evrenkenanoglu/smart_plugs_hw_design/UTILITY/JLCPCB_useful_component_list.md

# JLCPCB Useful Component List

BUTTONS
| Supplier Part | Description |
| --- | --- |
| C455095 | 6x6x7mm Tactile Switch |
