evrenkenanoglu/smart_plugs_hw_design/DESIGN/ESP32_RELATED/ESP32-S3-WROOM-1-N8R8.md

Here is the updated design note. I have integrated the detailed Strapping Pin configuration rules into **Section 4**, explaining exactly how to handle GPIO 0, 45, 46, and 3 to ensure the N8R8 module boots correctly every time.

```markdown
# Design Note: ESP32-S3 Headless Programming Interface
**Module:** ESP32-S3-WROOM-1-N8R8  
**Strategy:** No User UART. Factory Programming via 6-Pin Header only.  
**Logic:** Auto-Program Circuit (Transistors) located on External Tool.

## 1. Schematic Diagram (ASCII)

```text
       [ EXTERNAL PROGRAMMER ]                 [ YOUR PCB ]
       (USB to TTL + Auto-Logic)          (Internal Components)

      +-------------------------+        +---------------------------+
      |                         |        |                           |
      |   FTDI / ESP-PROG       |        |   ESP32-S3-WROOM-1        |
      |      (External)         |        |      (Top View)           |
      |                         |        |                           |
      +------------+------------+        +-------------+-------------+
                   |                                   |
           [ 6-PIN CONNECTOR ]                  [ MODULE PINS ]
                   |                                   |
                   v                                   v
      +-------------------------+        +---------------------------+
      |  1. GND                 |--------| Pin 1, 40, 41, 42 (GND)   |
      |                         |        |                           |
      |  2. 3V3 (Target Power)  |---+----| Pin 2 (3V3)               |
      |                         |   |    |                           |
      |                         | [C1,C2]|                           |
      |                         |   |    |                           |
      |                         |  GND   |                           |
      |                         |        |                           |
      |  3. TXD (Log Output)    |--------| Pin 37 (GPIO 43 / U0TXD)  |
      |                         |        |                           |
      |  4. RXD (Data Input)    |--------| Pin 36 (GPIO 44 / U0RXD)  |
      |                         |        |                           |
      |  5. IO0 (Boot Control)  |---+----| Pin 27 (GPIO 0 / BOOT)    |
      |                         |   |    |                           |
      |                         |  [R2]  |                           |
      |                         |   |    |                           |
      |                         |  3V3   |                           |
      |                         |        |                           |
      |  6. RST (Chip Reset)    |---+----| Pin 3 (EN / CHIP_PU)      |
      |                         |   |    |                           |
      |                         |  [R1]  |                           |
      |                         |   |    |                           |
      |                         |  3V3   |                           |
      |                         |        |                           |
      |                         |  [C3]  |                           |
      |                         |   |    |                           |
      |                         |  GND   |                           |
      +-------------------------+        +---------------------------+
```

---

## 2. Component Values (BOM)

| Component | Value | Function | Placement Note |
| :--- | :--- | :--- | :--- |
| **C1** | **10µF** (10V+) | Bulk Power Storage | Close to Module Pin 2 |
| **C2** | **0.1µF** (100nF) | High Freq Decoupling | **Closest** to Module Pin 2 |
| **R1** | **10kΩ** | EN Pull-Up | Anywhere on EN net |
| **C3** | **1µF** | EN RC Delay (Reset Timing) | Close to Module Pin 3 |
| **R2** | **10kΩ** | IO0 Pull-Up (Stability) | Anywhere on IO0 net |

### Connection Diagram of 10uF and 0.1uF Capacitors

```text
      3.3V Source (LDO)
            |
            +-------------+-------------+----------------> Pin 2 (ESP32 3V3)
            |             |             |
          [ C1 ]        [ C2 ]          |
           10µF         0.1µF           |
            |             |             |
      ------+-------------+-------------+----------------> GND
            |
         GND Plane
```

### Physical Layout (Crucial)
While they are electrically in parallel, their **physical position** on the PCB matters:

1.  **Pin 2 (ESP32):** The target.
2.  **C2 (0.1µF):** Place this **closest** to Pin 2. It filters high-frequency noise.
3.  **C1 (10µF):** Place this right behind C2. It acts as a customized energy reservoir.

**Order on PCB:** `[Pin 2] <--- [0.1µF] <--- [10µF] <--- [Power Source]`

---

## 3. Pin Mapping Table (Netlist)

This mapping assumes a standard 1x6 Pin Header (2.54mm) on the PCB.

| Header Pin | Net Name | ESP32-S3 Pin | ESP32 Function | Description |
| :--- | :--- | :--- | :--- | :--- |
| **1** | `GND` | **1, 40, 41, 42** | GND | Common Ground |
| **2** | `+3V3` | **2** | 3V3 | Power for flashing (if unpowered) |
| **3** | `UART_TX` | **37** | GPIO 43 | **U0TXD** (Serial Output) |
| **4** | `UART_RX` | **36** | GPIO 44 | **U0RXD** (Serial Input) |
| **5** | `PROG_IO0`| **27** | GPIO 0 | Boot Mode Selection |
| **6** | `PROG_RST`| **3** | EN | Chip Enable / Reset |

---

## 4. Strapping Pin Configuration (Crucial)

These pins are sampled at the moment of Reset (Latch). Incorrect connections here will prevent the board from booting or cause "ghost" failures.

| Module Pin | Function | Schematic Action | Why? |
| :--- | :--- | :--- | :--- |
| **GPIO 0** (Pin 27) | Boot Mode | **10kΩ Pull-Up** | Must be HIGH to run code. External tool pulls LOW to flash. |
| **GPIO 46** (Pin ?) | ROM Log / Voltage | **FLOAT** (Do not connect) | Default is Pull-Down (0). Pulling HIGH can disable ROM messages or change boot voltage. |
| **GPIO 45** (Pin 26) | VDD_SPI Voltage | **FLOAT** (Do not connect) | Default is Pull-Down (0) for 3.3V Flash. Pulling HIGH forces 1.8V, which kills communication with N8R8 Flash. |
| **GPIO 3** (Pin 18) | JTAG | **FLOAT** (Do not connect) | Default is Floating. No action needed unless using JTAG. |

**Golden Rule:** If you have extra pins available, leave GPIO 46, 45, and 3 completely unconnected to ensure maximum stability.

---

## 5. Layout & Tooling Notes

1.  **Thermal Pad (Pin 42):**
    *   Must be connected to **GND**.
    *   Add at least **9 vias** on the PCB footprint to the bottom ground plane for heat dissipation.
2.  **External Programmer Tool:**
    *   Use a tool like **ESP-Prog** or a USB-TTL adapter with **Auto-Program Logic**.
    *   *Standard 6-pin FTDI cables will NOT work for auto-upload unless you manually manipulate wires.*
```
