evrenkenanoglu/smart_plugs_hw_design/DESIGN/SCRIPTS/POWER_CALCULATIONS/Power_Calculations/Report_Main_Power_Board.md

# 🏗️ PCB ENGINEERING REPORT: Smart Plug System v2 - Main_Power_Board
**Date:** 2026-03-03  
**Spec:** 1.0oz Copper | 230.0V AC | 5.0V DC  
**Standard:** IPC-2221 / IEC 60950-1  

---

## 🔋 PART 1: POWER SUPPLY LOAD ANALYSIS
**Objective:** Verify if `HLK-10M05` (2000.0 mA) can handle the Worst-Case Peak loads.

| COMPONENT | PEAK (mA)| QTY | CURRENT (mA) | TOTAL (mA) |
| :--- | :--- | :--- | :--- | :--- |
| HF115F Relay Coils | 5.0V | 4 | 80.0 | 320.0 |
| ESP32-WROOM-32UE | 3.3V | 1 | 700.0 | 700.0 |
| UI Board Feed (LEDs) | 5.0V | 4 | 12.0 | 48.0 |

* **TOTAL PEAK:** `1068.0 mA`
* **DESIGN LOAD (+20%):** `1281.6 mA`
* **STATUS:** ✅ **PASS**

---

## ⚡ PART 2: AC HIGH POWER ANALYSIS
| LINE NAME | VOLTAGE | MAX AMPS | POWER (kW) |
| :--- | :--- | :--- | :--- |
| AC_LOAD_16A | 230.0V | 16.000 A | 3.680 kW |
| AC_MAINS_INPUT_LOGIC | 230.0V | 0.200 A | 0.046 kW |
| AC_MAINS_INPUT | 230.0V | 0.040 A | 0.009 kW |

---

## 📏 PART 3: TRACE WIDTH RULES
**Parameters:** 1.0oz Copper, +10°C Rise.

| NET FUNCTION | LOAD (A) | MIN WIDTH (Calc) | **ALTIUM RULE (Rec)** |
| :--- | :--- | :--- | :--- |
| AC_LOAD_16A | 16.000 | 13.837 mm | **POLYGON POUR** |
| AC_MAINS_INPUT_LOGIC | 0.200 | 0.250 mm | **1.00 mm** (Mech) |
| AC_MAINS_INPUT | 0.040 | 0.250 mm | **1.00 mm** (Mech) |
| DC_IN_5.0V | 1.282 | 0.425 mm | **1.10 mm** (SF=2.5) |
| DC_3V3_RAIL | 0.700 | 0.250 mm | **0.65 mm** (SF=2.5) |
| DC_RELAY_GND | 0.320 | 0.250 mm | **0.65 mm** (SF=2.5) |
| DC_SIGNAL | 0.050 | 0.250 mm | **0.25 mm** |

> **⚠️ CRITICAL NOTE for AC_LOAD_20A:**  
> Use a **Solid Polygon Pour** connecting the Relay Pin to the Faston Tab.

---

## 🛡️ PART 4: SAFETY SPACING RULES
**Standards:** IEC 60950-1 (Pollution Degree 2).

| ZONE A | ZONE B | STD CLEARANCE | STD CREEPAGE | **RECOMMENDED RULE** |
| :--- | :--- | :--- | :--- | :--- |
| AC Phase | AC Neutral | 1.5 mm | 2.5 mm | **3.0 mm** (Robust) |
| AC Mains | DC Logic | 3.0 mm | 5.0 mm | **6.0 mm** (or Slot) |
| AC Relay Pin | Faston Tab | N/A | N/A | **Connect w/ Polygon** |
| DC 5V | DC GND | 0.15 mm | 0.15 mm | **0.25 mm** |

---
*Generated by PCB Engineering Assistant*
