evrenkenanoglu/smart_plugs_hw_design/DESIGN/SCRIPTS/POWER_CALCULATIONS/Power_Calculations/Report_UI_Control_Board.md

# 🏗️ PCB ENGINEERING REPORT: Smart Plug System v2 - UI_Control_Board
**Date:** 2026-03-03  
**Spec:** 1.0oz Copper | 0.0V AC | 5.0V DC  
**Standard:** IPC-2221 / IEC 60950-1  

---

## 🔋 PART 1: POWER SUPPLY LOAD ANALYSIS
**Objective:** Verify if `HLK-10M05` (2000.0 mA) can handle the Worst-Case Peak loads.

| COMPONENT | PEAK (mA)| QTY | CURRENT (mA) | TOTAL (mA) |
| :--- | :--- | :--- | :--- | :--- |
| Status LEDs | 5.0V | 4 | 12.0 | 48.0 |
| Tactile Buttons | 0.0V | 4 | 1.0 | 4.0 |

* **TOTAL PEAK:** `52.0 mA`
* **DESIGN LOAD (+15%):** `59.8 mA`
* **STATUS:** ✅ **PASS**

---

## ⚡ PART 2: AC HIGH POWER ANALYSIS
| LINE NAME | VOLTAGE | MAX AMPS | POWER (kW) |
| :--- | :--- | :--- | :--- |
| N/A | N/A | N/A | N/A |

---

## 📏 PART 3: TRACE WIDTH RULES
**Parameters:** 1.0oz Copper, +10°C Rise.

| NET FUNCTION | LOAD (A) | MIN WIDTH (Calc) | **ALTIUM RULE (Rec)** |
| :--- | :--- | :--- | :--- |
| DC_IN_5.0V | 0.060 | 0.250 mm | **0.25 mm** |
| DC_3V3_RAIL | 0.004 | 0.250 mm | **0.25 mm** |
| DC_SIGNAL | 0.050 | 0.250 mm | **0.25 mm** |

> **⚠️ CRITICAL NOTE for AC_LOAD_20A:**  
> Use a **Solid Polygon Pour** connecting the Relay Pin to the Faston Tab.

---

## 🛡️ PART 4: SAFETY SPACING RULES
**Standards:** IEC 60950-1 (Pollution Degree 2).

| ZONE A | ZONE B | STD CLEARANCE | STD CREEPAGE | **RECOMMENDED RULE** |
| :--- | :--- | :--- | :--- | :--- |
| AC Phase | AC Neutral | 1.5 mm | 2.5 mm | **3.0 mm** (Robust) |
| AC Mains | DC Logic | 3.0 mm | 5.0 mm | **6.0 mm** (or Slot) |
| AC Relay Pin | Faston Tab | N/A | N/A | **Connect w/ Polygon** |
| DC 5V | DC GND | 0.15 mm | 0.15 mm | **0.25 mm** |

---
*Generated by PCB Engineering Assistant*
