evrenkenanoglu/smart_plugs_hw_design/DESIGN/SCRIPTS/POWER_CALCULATIONS/Led_Calculations/report.md

# UI LED Calculation & BOM Report

| Component Name | Source | Target mA | Req. Ω | E24 Choice | Power (mW) |
| :--- | :--- | :--- | :--- | :--- | :--- |
| System Status (White) | 3.3V | 12 | 33.3Ω | **33Ω** | 4.8 |
| System Status (White) | 5.0V | 11 | 190.9Ω | **200Ω** | 24.2 |
