evrenkenanoglu/smart_plugs_hw_design/PCB_DESIGN/Smart_Plugs_EasyEDA/Releases/v0.3.0/BOM_Combined_PCB_COMBINED_2026-03-11_v0.3.0.csv

No. | Quantity | Comment | Designator | Footprint | Value | Manufacturer Part | Manufacturer | Supplier Part | Supplier
1 | 1 | 100nF | C1 | CAP-TH_L4.0-W2.5-P5.00-D1.0 | 100nF | FG28X7R1H104KNT06 | TDK | C342794 | LCSC
2 | 1 | 100nF | C2 | CAP-TH_L13.0-W6.0-P10.00-D1.0 | 100nF | MP2104K27C3X6LC | SRD(圣融达) | C105759 | LCSC
3 | 2 | 10uF | C3,C11 | C0603 | 10uF | CL10A106KP8NNNC | SAMSUNG(三星) | C19702 | LCSC
4 | 1 | 10uF | C4 | CAP-TH_BD10.0-P5.00-D1.0-FD | 10uF | EGD2WM100G16OT | AISHI(艾华集团) | C106328 | LCSC
5 | 7 | 100nF | C5,C6,C7,C9,C12,C13,C14 | C0402 | 100nF | CL05B104KO5NNNC | SAMSUNG(三星) | C1525 | LCSC
6 | 1 | 1uF | C8 | C0402 | 1uF | CL05A105KO5NNNC | SAMSUNG(三星) | C29266 | LCSC
7 | 1 | 22uF | C10 | C1206 | 22uF | CL31A226KAHNNNE | SAMSUNG(三星) | C12891 | LCSC
8 | 2 | XH-12A | CN1,CN2 | CONN-TH_12P-P2.50_XH-12A |  | XH-12A | BOOMELE(博穆精密) | C8880 | LCSC
9 | 1 | 2.2nF | CY1 | CAP-TH_L8.5-W5.0-P10.00-D0.6 | 2.2nF | Y16F1D222M | HEL(鸿志) | C332369 | LCSC
10 | 2 | 220uF | C_BULK1,C_BULK2 | CAP-TH_BD6.3-P2.50-D1.0-FD | 220uF | ERS1EM221E11OT | AISHI(艾华集团) | C141282 | LCSC
11 | 4 | B5819W SL | D1,D2,D3,D4 | SOD-123_L2.7-W1.6-LS3.7-RD-1 |  | B5819W SL | CJ(江苏长电/长晶) | C8598 | LCSC
12 | 1 | SMBJ5.0A | D5 | SMB_L4.6-W3.6-LS5.3-RD |  | SMBJ5.0A | Brightking(君耀电子) | C78423 | LCSC
13 | 1 | PTF-77 | FH1 | FUSE-TH_L24.4-W9.4-P22.60 |  | PTF-77 | XFCN(兴飞) | C717030 | LCSC
14 | 8 | EST026 | FT_IN1,FT_IN2,FT_IN3,FT_IN4,FT_OUT1,FT_OUT2,FT_OUT3,FT_OUT4 | CONN-TH_L6.3-W0.8-EST026 |  | EST026 | xcfuse(旭程) | C52878 | LCSC
15 | 4 | Socket | J1,J2,J3,J4 | PIN1
16 | 4 | HF115F-I/005-1HS3A | K1,K2,K3,K4 | RELAY-TH_HF115F-XXX-1HS3 |  | HF115F-I/005-1HS3A | HF(宏发) | C2976795 | LCSC
17 | 1 | UU9.8-10mH | L1 | FILTER-TH_4P-L17.0-W12.0-P7.00-D0.6-S8.00 |  | UU9.8-10mH | FH(风华) | C148474 | LCSC
18 | 1 | 10uH | L2 | IND-SMD_L7.0-W7.0_SMDRS70XX | 10uH | SLF7055T-100M2R5-3PF | TDK | C92044 | LCSC
19 | 5 | KT-0805W | LED1,LED2,LED3,LED4,LED5 | LED0805-R-RD |  | KT-0805W | KENTO | C34499 | LCSC
20 | 1 | HNTC0805-103F3950FB | NTC1 | R0805 |  | HNTC0805-103F3950FB | R+O(宏嘉诚) | C49247662 | LCSC
21 | 1 | 10D-7 | NTC2 | RES-TH_L9.0-W4.7-P5.00-D1.2-S1.70 |  | 10D-7 | HEL(鸿志) | C332360 | LCSC
22 | 1 | KF7.62-3P | P1 | CONN-TH_KF7.62-3P |  | KF7.62-3P | KEFA(科发) | C707825 | LCSC
23 | 1 | 2.54-1*6P母 | P2 | HDR-TH_6P-P2.54-V-F |  | 2.54-1*6P母 | BOOMELE(博穆精密) | C40877 | LCSC
24 | 4 | SS8050(RANGE:200-350) | Q1,Q2,Q3,Q4 | SOT-23-3_L2.9-W1.3-P1.90-LS2.4-BR |  | SS8050(RANGE:200-350) | CJ(江苏长电/长晶) | C2150 | LCSC
25 | 8 | 10kΩ | R1,R6,R7,R9,R12,R14,R15,R21 | R0805 | 10kΩ | 0805W8F1002T5E | UNI-ROYAL(厚声) | C17414 | LCSC
26 | 8 | 1kΩ | R2,R3,R4,R5,R10,R13,R16,R20 | R0805 | 1kΩ | 0805W8F1001T5E | UNI-ROYAL(厚声) | C17513 | LCSC
27 | 4 | 200Ω | R8,R11,R18,R19 | R0805 | 200Ω | 0805W8F2000T5E | UNI-ROYAL(厚声) | C17540 | LCSC
28 | 1 | 33Ω | R17 | R0805 | 33Ω | 0805W8F330JT5E | UNI-ROYAL(厚声) | C17634 | LCSC
29 | 1 | 440pF | RV1 | RES-TH_L14.5-W6.0-P7.50-D0.8-S6.0 | 440pF | 14D431K | R+O(宏嘉诚) | C49069732 | LCSC
30 | 4 | TS-1103ST-C-B | SW1,SW2,SW3,SW4 | KEY-SMD_4P-L12.0-W12.0-P5.00-LS15.1 |  | TS-1103ST-C-B | XKB Connection(中国星坤) | C318913 | LCSC
31 | 1 | HLK-5LS05 | U1 | PWRM-TH_HLK-5LSXX |  | HLK-5LS05 | HI-LINK(海凌科) | C48935101 | LCSC
32 | 1 | ESP32-C6-WROOM-1-N8 | U2 | WIRELM-SMD_ESP32-C6-WROOM-1 |  | ESP32-C6-WROOM-1-N8 | ESPRESSIF(乐鑫) | C5366877 | LCSC
33 | 1 | AMS1117-3.3 | U3 | SOT-223-3_L6.5-W3.4-P2.30-LS7.0-BR |  | AMS1117-3.3 | AMS | C6186 | LCSC
