evrenkenanoglu/smart_plugs_hw_design/(list of files, drawings)

Other design files:
PCB_DESIGN/Smart_Plugs/Smart_Plugs.PrjPcb
PCB_DESIGN/Smart_Plugs/Sources/Button_Input_Block.SchDoc
PCB_DESIGN/Smart_Plugs/Sources/Earth_Connectors.SchDoc
PCB_DESIGN/Smart_Plugs/Sources/I2C.SchDoc
PCB_DESIGN/Smart_Plugs/Sources/IO_Expander.SchDoc
PCB_DESIGN/Smart_Plugs/Sources/IO_Expander_Interrupt_Block.SchDoc
PCB_DESIGN/Smart_Plugs/Sources/MAIN.SchDoc
PCB_DESIGN/Smart_Plugs/Sources/PSU.SchDoc
PCB_DESIGN/Smart_Plugs/Sources/Relay_Channel.SchDoc
PCB_DESIGN/Smart_Plugs/Sources/Relay_Driver.SchDoc
PCB_DESIGN/Smart_Plugs/Sources/Reset_Block.SchDoc
PCB_DESIGN/Smart_Plugs/Sources/Smart_Plug_PCB.PcbDoc
PCB_DESIGN/Smart_Plugs/Sources/System_Controller.SchDoc
PCB_DESIGN/Smart_Plugs_EasyEDA/Smart_Plug_Design_Rules_Export_1_Oz.json
PCB_DESIGN/Smart_Plugs_EasyEDA/Smart_Plug_Design_Rules_Export_2_Oz.json
PCB_DESIGN/Smart_Plugs_EasyEDA/Smart_Plugs.eprj
PCB_DESIGN/Smart_Plugs_EasyEDA/Smart_Plugs_Design_Rules_NC-NC.json
PCB_DESIGN/Smart_Plugs_EasyEDA/Smart_Plugs_LV_Only_DR1.json
