evrenkenanoglu/smart_plugs_hw_design/(commit log)

2026-01-23 Add script for cleaning, copying, and zipping Altium Gerber files
2026-01-23 Add new schematic libraries of terminal blocks and update the pcb design
    [PSU.SchDoc, Relay_Channel.SchDoc, Smart_Plug_PCB.PcbDoc, Smart_Plugs.PrjPcb]
2026-01-23 Add bjt_transistor library and update pcb
    [Relay_Channel.SchDoc, Smart_Plug_PCB.PcbDoc, Smart_Plugs.PrjPcb]
2026-01-23 Add Manufacturing.OutJob configuration for PCB output settings
2026-01-24 Add button library and update the pcb
    [Button_Input_Block.SchDoc, Smart_Plug_PCB.PcbDoc, Smart_Plugs.PrjPcb]
2026-01-24 Add new button library and update the pcb
    [Button_Input_Block.SchDoc, Smart_Plug_PCB.PcbDoc, Smart_Plugs.PrjPcb]
2026-01-24 Update I2C schematic design file
    [I2C.SchDoc]
2026-01-27 Add power calculations script and components JSON file
2026-01-27 Refactor power calculations script and update components JSON for Smart Plug project
2026-01-27 Add PCB engineering report and peak data JSON for Smart Plug project
2026-02-01 Add safety report generation script and initial report template for Smart Power Bar project
2026-02-01 Update PCB engineering report and related calculations for Smart Plug project
2026-02-01 Add PCB engineering report, peak data JSON, and power calculations script for Smart Plug project
2026-02-01 Refactor PCB engineering report and power calculations script for improved clarity and accuracy
2026-02-01 Add power analysis scripts and configuration for PCB design calculations
2026-02-03 Add new component libraries and update the design
    [Button_Input_Block.SchDoc, I2C.SchDoc, IO_Expander.SchDoc, MAIN.SchDoc, PSU.SchDoc, Relay_Channel.SchDoc, Relay_Driver.SchDoc, Reset_Block.SchDoc]
2026-02-03 Update Smart Plug PCB design file
    [Smart_Plug_PCB.PcbDoc]
2026-02-03 Add new library and update mcp23017
    [IO_Expander.SchDoc, Smart_Plug_PCB.PcbDoc]
2026-02-03 Update pcb
    [Smart_Plug_PCB.PcbDoc]
2026-02-03 Update kanban board
2026-02-05 Add Interrupt Connection Block
    [IO_Expander.SchDoc, IO_Expander_Interrupt_Block.SchDoc, MAIN.SchDoc, MCU_Core.SchDoc, Smart_Plug_PCB.PcbDoc, Smart_Plugs.PrjPcb]
2026-02-07 Update ESP32 with 2x19 Pin Headers
    [MAIN.SchDoc, MCU_Core.SchDoc, Smart_Plug_PCB.PcbDoc, Smart_Plugs.PrjPcb]
2026-02-07 Update footprint of AMS1117-3.31
    [PSU.SchDoc, Smart_Plug_PCB.PcbDoc]
2026-02-07 Add Board Name
    [Smart_Plug_PCB.PcbDoc]
2026-02-07 Update Fuse holder and varistor
    [PSU.SchDoc, Smart_Plug_PCB.PcbDoc]
2026-02-07 Update the pcb name tag
    [Smart_Plug_PCB.PcbDoc]
2026-02-07 Update Smart Plug PCB design
    [Smart_Plug_PCB.PcbDoc]
2026-02-07 Change Fuse Holder due an error with previous one on PCB Design Output in JLCPCB
    [PSU.SchDoc, Smart_Plug_PCB.PcbDoc]
2026-02-07 Change Faston Tabs
    [Relay_Channel.SchDoc, Smart_Plug_PCB.PcbDoc]
2026-02-10 Add Export_As_ASCII job configuration file for schematic and PCB outputs
2026-02-10 Refactor code structure for improved readability and maintainability
    [Button_Input_Block.SchDoc, Earth_Connectors.SchDoc, I2C.SchDoc, IO_Expander.SchDoc, IO_Expander_Interrupt_Block.SchDoc, MAIN.SchDoc, MCU_Core.SchDoc, Output_Power_Channel.SchDoc]
2026-02-10 Update binary files for Smart Plug schematic and PCB design
    [MAIN.SchDoc, Smart_Plug_PCB.PcbDoc]
2026-02-11 Testing EasyEDA
    [Smart_Plugs.eprj]
2026-02-13 Add export of the rules for reusability and update the project
    [Smart_Plug_Design_Rules_Export.json, Smart_Plugs.eprj, Smart_Plugs_Design_Rules_NC-NC.json]
2026-02-14 Update project
    [Smart_Plugs.eprj]
2026-02-14 Try remove IO Expander from this point
    [Smart_Plugs.eprj]
2026-02-14 Add ESP32 S3 pcb design details
2026-02-18 Add Led resistor selection calculation
2026-02-18 Update power supply design
2026-02-18 Create UI board
    [Smart_Plugs.eprj]
2026-02-22 Update the pcb design
    [Smart_Plugs.eprj]
2026-02-22 Update as unknown pin number of 46
2026-02-22 Major Decision: Start moving esp32 to the UI board
    [Smart_Plugs.eprj]
2026-02-22 Add backup files for Smart Plugs PCB design versions
2026-03-01 Update the relay 16A 4000W
2026-03-03 Small Update
    [Smart_Plugs.eprj]
2026-03-03 Update smart plugs
    [Smart_Plugs.eprj]
2026-03-03 Update project details
    [Smart_Plug_Design_Rules_Export_1_Oz.json, Smart_Plug_Design_Rules_Export_2_Oz.json]
2026-03-04 Improvements in AC-DC converter size
    [Smart_Plugs.eprj]
2026-03-04 Update Smart Plugs project file
    [Smart_Plugs.eprj]
2026-03-07 UI finalized for the first version
    [Smart_Plugs.eprj]
2026-03-10 Update UI, MAIN and COMBINED for the manufacturing
    [Smart_Plugs.eprj]
2026-03-10 Update PCB engineering report with critical notes and safety spacing rules
2026-03-10 Add detailed design documentation for ESP32-C6-WROOM-1-N8 and UI mechanical stack-up
2026-03-10 Add Clearance_HV_Exception spacing rules and refine stroke width values in design rules
    [Smart_Plug_Design_Rules_Export_1_Oz.json]
2026-03-10 Update spacing values and add copper region direct connect rules in design file
    [Smart_Plug_Design_Rules_Export_1_Oz.json]
2026-03-11 Ready For Manufacture
    [Smart_Plugs.eprj]
2026-03-11 Add new BOM, Gerber, and Pick and Place files for v0.3.0 release
    [BOM_Combined_PCB_COMBINED_2026-03-11_v0.3.0.csv, PickAndPlace_PCB_COMBINED_2026-03-11_v0.3.0.csv]
2026-03-13 Update project with OMRON relay
    [Smart_Plugs.eprj]
